fact-project/ShutterController/docs/shutter_sketch.pdf

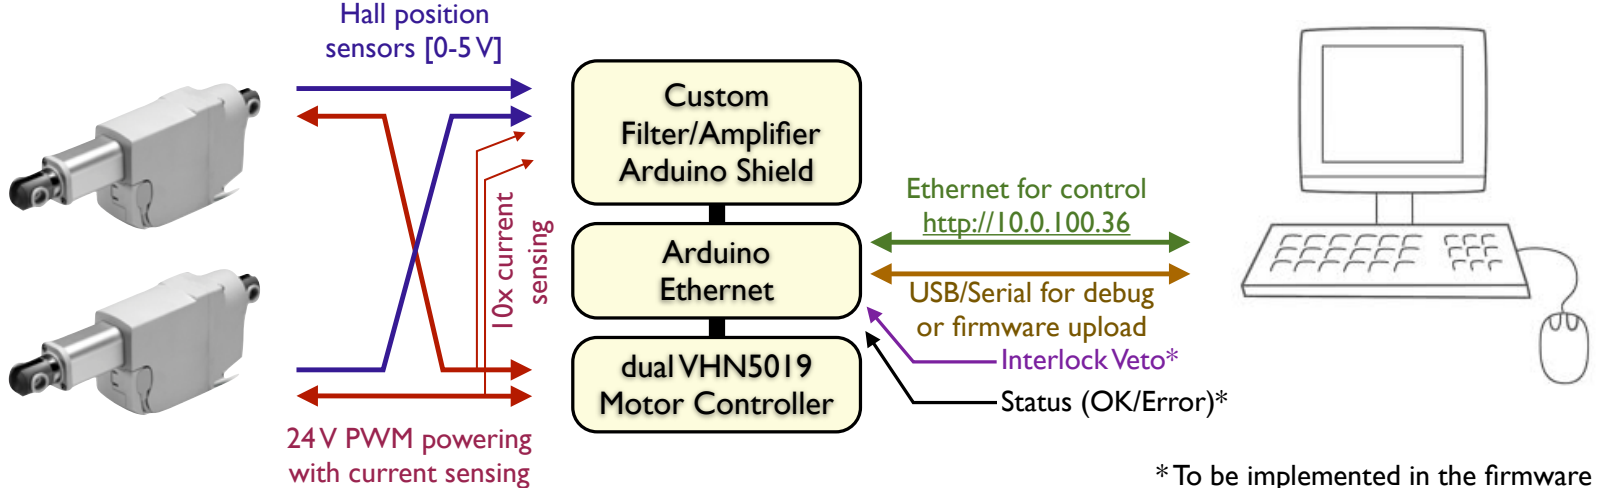
[picture p6: page 1]

Custom
Filter/Amplifier
Arduino Shield

Arduino
Ethernet

dual VHN5019
Motor Controller

Hall position
sensors [0-5 V]

24 V PWM powering

with current sensing¹⁰x current sensing

Ethernet for control
http://10.0.100.36

USB/Serial for debug
or firmware upload
Interlock Veto*
Status (OK/Error)*

* To be implemented in the firmware
