fact-project/ShutterController/docs/pololu_sch.jpg

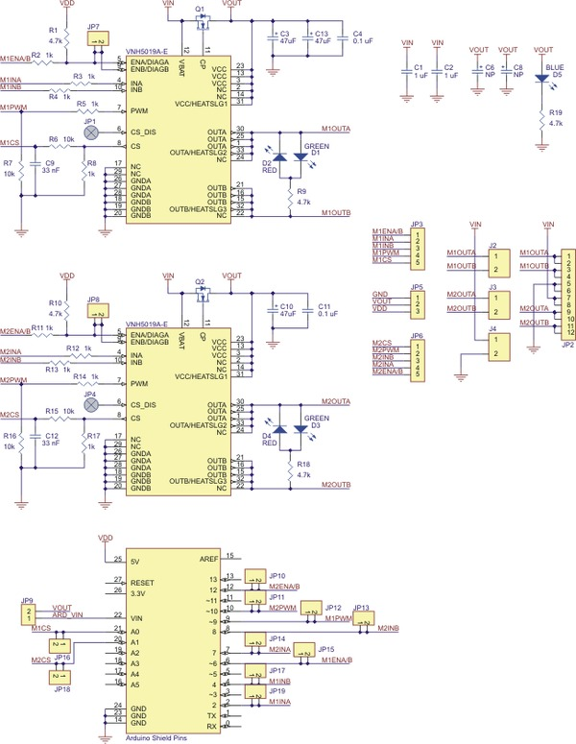
docs/pololu_sch.jpg
