fact-project/ShutterController/docs/dpnc303_sch.pdf

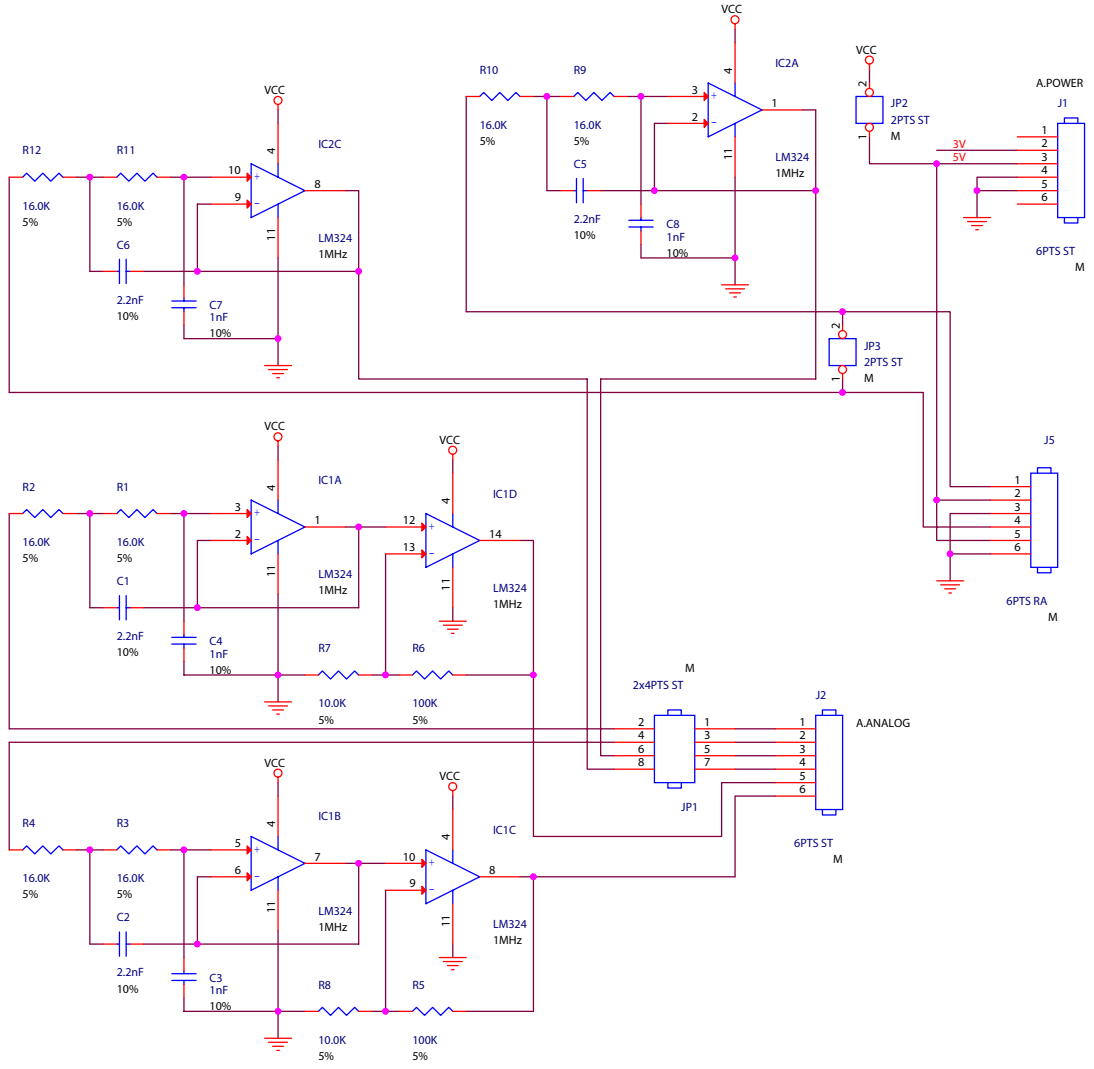
[picture p8: page 1]
