fact-project/ShutterController/docs/LA23_cable.pdf

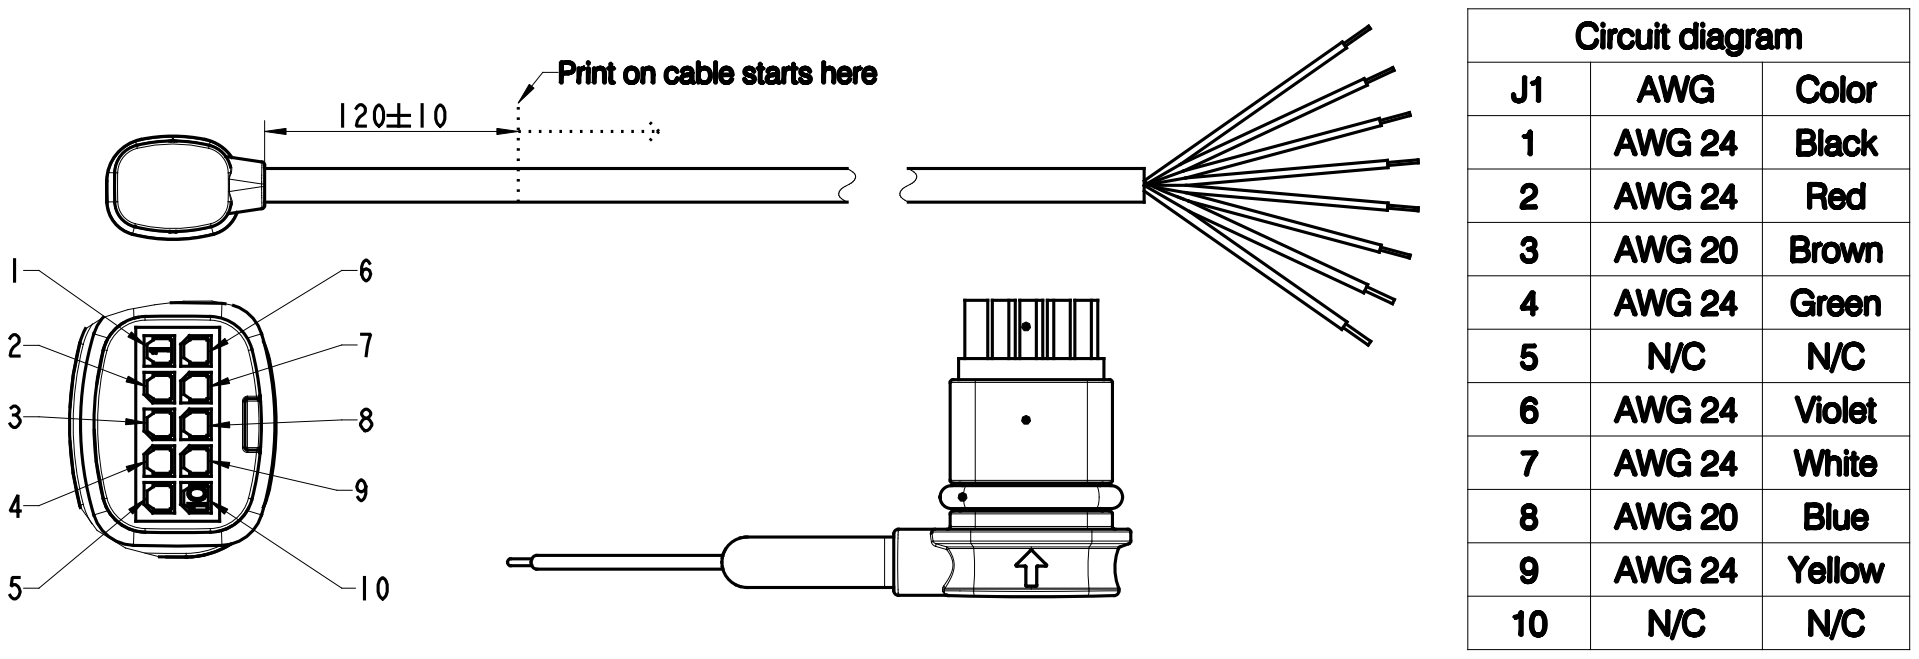
[picture p9: page 1]
