fact-project/ShutterController/(commit log)

2017-01-03 add function prototypes and whitespace:
    after renaming ino to cpp, we need to follow real C(++) rules again
    and state the function prototypes for the compiler explicitely
    a lot of whitespaces at the end of lines were removed by the
    editor
2017-01-03 add motor shield library
2017-01-03 change PWM pins from 9,10 to 5,6 --> Note different Timer needed! TBD
2017-01-03 Replace Timer 1 by Timer 0.
    Timer 0 is 8 bit, so all 400 -> 255
    [DualVNH5019MotorShield.cpp]
2017-01-03 Timer 0 has the registers inverted:
    PD5 - "5" toggles on OC0B and
    PD6 - "6" toggles on OC0A
    [DualVNH5019MotorShield.cpp]
2017-01-03 remove all EN/DIAG functionality as we don't know how it was wired. Looks like it was not wired at all. It is not necessary for motor control after all.
2017-01-03 remove unused images and start using dual motor shield library
2017-01-03 add function, so we can choose the motor by an integer
2017-01-03 use library to set motor speed
2017-01-04 add class to read the hall sensors
2017-01-04 use new class to for reading hall sensors
2017-01-04 finish replacement of ReadSensor by new LinakHallSensor.get
    [ShutterController.cpp]
2017-01-04 add method to get the mean hall sensor value over many measurements
2017-01-04 add methods to average current consumption
2017-01-04 use DualVNH5019MotorShield.get_mean()
    note missing side effects!
    ReadCurrentM() had side effects, which get_mean() does not have.
    So the global _currentValue is addigned explicitely
    [ShutterController.cpp]
2017-01-04 remove unused function prototype
2017-01-04 add get_mean_std() to MotorShield and HallSensor
2017-01-04 add method to ramp motor up to speed in a trivial and blocking way.
2017-01-04 add forgotten function prototype
2017-01-04 remove all Serial.print calls, as they are only for debugging
    and add no functionality to the program. At best they are confusing
2017-01-04 remove calculation of values only needed for Serial.print statements
2017-01-04 no! no fancy speed adjusting algos needed at all!
    ... even ramping the speed up from zero to 255 is not needed.
    The linak motors can nicely handle immediate full throttle
2017-01-04 add overcurrent check to MotorShield
2017-01-04 remove steps variable, only needed for printing and
    let the main while loop really be a while loop
2017-01-04 add check for zero current
2017-01-04 first power the motor, then check for over current
2017-01-04 avoid int overflow on multiplication
    [DualVNH5019MotorShield.cpp, LinakHallSensor.cpp]
2017-01-04 show also current speed
2017-01-04 send status in any case
2017-01-05 fix current measurement - take preamp factor 10 into account
    [DualVNH5019MotorShield.cpp]
2017-01-05 auto check for over current again
2017-01-08 add functions for integer statistics on ADC pin measurements
2017-01-08 use tools::get_mean and tools::get_mean_std
    currents are not in mA anymore but in ADC counts ...
2017-01-08 put pin definitions into MotorShield ctor
2017-01-08 put pin definition into HallSensor ctor
2017-01-08 store also number of samples
2017-01-10 multiply all delays by 64, as we have changed the Timer0 prescaler
2017-01-10 raise lower limit for "ZeroCurrent" a bit, so inner motor switches of earlier.
2017-03-21 change zero current limit; needed after arduino change
